amriHaneef/Robotic_Arduino/README.md

# Robotic_Arduino
Automated measuring and dipersion system
